inclusion-international/Adapted-Wireless-Wheely-Joystick-for-Gaming/Photos/Architecture-simple.png

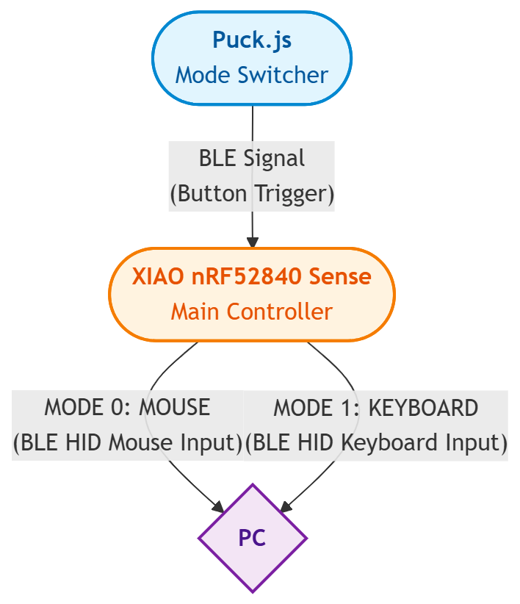
Photos/Architecture-simple.png
