inclusion-international/Adapted-Wireless-Wheely-Joystick-for-Gaming/Photos/Wireless-Knee-Button.png

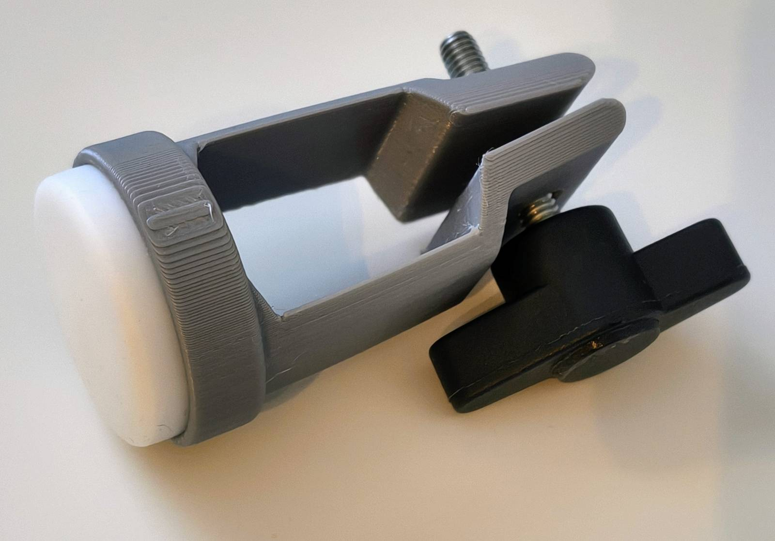
Photos/Wireless-Knee-Button.png
