inclusion-international/Adapted-Wireless-Wheely-Joystick-for-Gaming/src/xiao/XIAO-nRF52840-Sense/XIAO-nRF52840-Sense.ino

/*
 * XIAO nRF52840 Sense — MOUSE & KEYBOARD DUAL MODE
 * Features: -127 to +127 Integer Mapping, Wide Keyboard Deadzone, Hysteresis
 */

#include <bluefruit.h>
#include <LSM6DS3.h>
#include <Wire.h>

// ── HID REPORT DESCRIPTOR ────────────────────
uint8_t const desc_hid_report[] = {
  TUD_HID_REPORT_DESC_MOUSE(HID_REPORT_ID(1)),
  TUD_HID_REPORT_DESC_KEYBOARD(HID_REPORT_ID(2))
};

BLEHidGeneric blehid(2, 0, 0);

// ── IMU ──────────────────────────────────────
LSM6DS3 imu(I2C_MODE, 0x6A);

// ── CONNECTION STATE ──────────────────────────
volatile int mode = 1;  // 0 = Mouse, 1 = Keyboard
uint16_t pcConnHandle = BLE_CONN_HANDLE_INVALID;
uint16_t puckHandle = BLE_CONN_HANDLE_INVALID;

// ── KEYBOARD STATE VARIABLES ──────────────────
bool isUpPressed = false;
bool isDownPressed = false;
bool isLeftPressed = false;
bool isRightPressed = false;

// ── DEFERRED GATT DISCOVERY ───────────────────
volatile bool pendingPuckDiscovery = false;
volatile uint32_t puckConnectedAt = 0;
#define GATT_DISCOVERY_DELAY_MS 500

// ── PUCK UUIDS ───────────────────────────────
const uint8_t PUCK_SVC_UUID[] = {
  0xee, 0x86, 0x7d, 0x8e, 0x90, 0xa4, 0x4f, 0x0a,
  0x00, 0x0b, 0x00, 0x00, 0x0f, 0xf8, 0x71, 0xdf
};
const uint8_t PUCK_CHR_UUID[] = {
  0xee, 0x86, 0x7d, 0x8e, 0x90, 0xa4, 0x4f, 0x0a,
  0x00, 0x0b, 0x01, 0x00, 0x0f, 0xf8, 0x71, 0xdf
};

BLEClientService puckSvc(PUCK_SVC_UUID);
BLEClientCharacteristic puckChar(PUCK_CHR_UUID);

// ── HID SEND ──────────────────────────────────
void sendMouse(int8_t x, int8_t y) {
  if (pcConnHandle == BLE_CONN_HANDLE_INVALID) return;
  hid_mouse_report_t r = { 0 };
  r.x = x;
  r.y = y;
  blehid.inputReport(1, &r, sizeof(r));
}

void sendKeyboard() {
  if (pcConnHandle == BLE_CONN_HANDLE_INVALID) return;

  hid_keyboard_report_t r = { 0 };
  int keyIndex = 0;

  if (isUpPressed && keyIndex < 6) r.keycode[keyIndex++] = HID_KEY_W;
  if (isDownPressed && keyIndex < 6) r.keycode[keyIndex++] = HID_KEY_S;
  if (isLeftPressed && keyIndex < 6) r.keycode[keyIndex++] = HID_KEY_A;
  if (isRightPressed && keyIndex < 6) r.keycode[keyIndex++] = HID_KEY_D;

  blehid.inputReport(2, &r, sizeof(r));
}

// ── PUCK NOTIFY CALLBACK ──────────────────────
void notifyCb(BLEClientCharacteristic* chr, uint8_t* data, uint16_t len) {
  if (len > 0) {
    mode = data[0];
    Serial.printf("[PUCK] Mode -> %d (%s)\n",
                  mode, mode == 0 ? "MOUSE" : "KEYBOARD");

    if (mode == 0) {
      isUpPressed = isDownPressed = isLeftPressed = isRightPressed = false;
      sendKeyboard();
    }
  }
}

// ── SCAN CALLBACK ─────────────────────────────
void scanCb(ble_gap_evt_adv_report_t* report) {
  uint8_t nameBuf[32] = { 0 };
  uint8_t nameLen = Bluefruit.Scanner.parseReportByType(
    report, BLE_GAP_AD_TYPE_COMPLETE_LOCAL_NAME,
    nameBuf, sizeof(nameBuf));
  
// Configure the name of the Puck.js device to be used for the mode change (MOUSE/KEYBOARD).
  if (nameLen == 12 && memcmp(nameBuf, "Puck.js e11f", 3) == 0) {
    Serial.println("[SCAN] Found 'Puck.js', connecting...");
    Bluefruit.Scanner.stop();
    Bluefruit.Central.connect(report);
    return;
  } else {
    Serial.println("Could not find 'Puck.js'");
  }
  Bluefruit.Scanner.resume();
}

// ── CONNECT CALLBACK ──────────────────────────
void connectCb(uint16_t handle) {
  BLEConnection* conn = Bluefruit.Connection(handle);
  if (!conn) return;

  if (conn->getRole() == BLE_GAP_ROLE_PERIPH) {
    pcConnHandle = handle;
    conn->requestConnectionParameter(6, 12);
    Serial.println("[BLE] PC connected (HID host)");
  } else {
    puckHandle = handle;
    Bluefruit.Scanner.stop();
    conn->requestConnectionParameter(80, 160);
    pendingPuckDiscovery = true;
    puckConnectedAt = millis();
    Serial.println("[BLE] Puck link up — discovery scheduled in 500ms");
  }
}

// ── DISCONNECT CALLBACK ───────────────────────
void disconnectCb(uint16_t handle, uint8_t reason) {
  if (handle == pcConnHandle) {
    pcConnHandle = BLE_CONN_HANDLE_INVALID;
    isUpPressed = isDownPressed = isLeftPressed = isRightPressed = false;
    Serial.printf("[BLE] PC disconnected (reason=0x%02X)\n", reason);
    Bluefruit.Advertising.start(0);

  } else if (handle == puckHandle) {
    puckHandle = BLE_CONN_HANDLE_INVALID;
    pendingPuckDiscovery = false;
    Serial.printf("[BLE] Puck disconnected (reason=0x%02X)\n", reason);
    Bluefruit.Scanner.start(0);
  }
}

// ── SETUP ─────────────────────────────────────
void setup() {
  Serial.begin(115200);

  Wire.begin();
  Wire.setClock(400000);

  if (imu.begin() != 0) {
    Serial.println("[ERROR] IMU init failed");
    while (1)
      ;
  }

  Bluefruit.begin(1, 1);
  Bluefruit.setName("XIAO-HID");

  blehid.setReportMap(desc_hid_report, sizeof(desc_hid_report));
  blehid.begin();

  puckSvc.begin();
  puckChar.begin();

  Bluefruit.Periph.setConnectCallback(connectCb);
  Bluefruit.Periph.setDisconnectCallback(disconnectCb);
  Bluefruit.Central.setConnectCallback(connectCb);
  Bluefruit.Central.setDisconnectCallback(disconnectCb);

  Bluefruit.Advertising.addFlags(BLE_GAP_ADV_FLAGS_LE_ONLY_GENERAL_DISC_MODE);
  Bluefruit.Advertising.addAppearance(BLE_APPEARANCE_HID_MOUSE);
  Bluefruit.Advertising.addService(blehid);
  Bluefruit.Advertising.addName();
  Bluefruit.Advertising.start(0);

  Bluefruit.Scanner.setRxCallback(scanCb);
  Bluefruit.Scanner.useActiveScan(true);
  Bluefruit.Scanner.setInterval(160, 160);
  Bluefruit.Scanner.start(0);

  Serial.println("[SYSTEM] Ready");
}

// ── LOOP ──────────────────────────────────────
void loop() {
  static uint32_t lastPrintMs = 0;
  static uint32_t sendCount = 0;
  static uint32_t lastHidMs = 0;

  if (millis() - lastPrintMs >= 1000) {
    lastPrintMs = millis();
    if (sendCount > 0) Serial.printf("[HID] %lu report/s\n", sendCount);
    sendCount = 0;
  }

  if (pendingPuckDiscovery && (millis() - puckConnectedAt >= GATT_DISCOVERY_DELAY_MS)) {
    pendingPuckDiscovery = false;
    if (puckHandle != BLE_CONN_HANDLE_INVALID && puckSvc.discover(puckHandle) && puckChar.discover()) {
      puckChar.setNotifyCallback(notifyCb);
      puckChar.enableNotify();
      Serial.println("[GATT] Puck discovery OK + notify enabled");
    } else {
      Serial.println("[GATT] Puck discovery failed — forcing reconnect");
      if (puckHandle != BLE_CONN_HANDLE_INVALID) {
        Bluefruit.disconnect(puckHandle);
      }
    }
  }

    // ── SENSOR READING AND PROCESSING @ ~66Hz ─────────────────
  if (millis() - lastHidMs >= 15) {
    lastHidMs = millis();

    if (pcConnHandle == BLE_CONN_HANDLE_INVALID) return;

    float ax = imu.readFloatAccelX();
    float ay = imu.readFloatAccelY();

    if (mode == 0) {
      // ── MOUSE MODE ────────────────────────

      // Larger deadzone for DOWN movement
      const float MOUSE_DEADZONE_UP = 0.10f;
      const float MOUSE_DEADZONE_DOWN = 0.45f;

      // Corrected Y deadzone logic
      if (ay > -MOUSE_DEADZONE_UP && ay < MOUSE_DEADZONE_DOWN) {
        ay = 0.0f;
      }

      // X deadzone unchanged
      const float MOUSE_DEADZONE_X = 0.33f;
      if (fabs(ax) < MOUSE_DEADZONE_X) {
        ax = 0.0f;
      }

      int moveX = (int)(ax * 30.0f);
      int moveY = (int)(ay * 30.0f);

      if (moveX != 0 || moveY != 0) {
        int8_t fx = (int8_t)constrain(moveX, -127, 127);
        int8_t fy = (int8_t)constrain(moveY, -127, 127);

        sendMouse(-fx, fy);
        sendCount++;
      }

    } else {
      // ── KEYBOARD MODE ────────────────────────

      int valX = constrain((int)(ax * 127.0f), -127, 127);
      int valY = constrain((int)(ay * 127.0f), -127, 127);

      // Larger deadzone for S
      const int KEY_PRESS_UP = 20;    // W press threshold
      const int KEY_PRESS_DOWN = 35;  // S press threshold

      // FIXED HYSTERESIS (release thresholds must be LOWER)
      const int KEY_RELEASE_UP = 10;    // W release threshold
      const int KEY_RELEASE_DOWN = 20;  // S release threshold

      bool wantUp = false, wantDown = false, wantLeft = false, wantRight = false;

      // Y-axis decisions
      if (valY < -KEY_PRESS_UP) wantUp = true;
      else if (valY > KEY_PRESS_DOWN) wantDown = true;

      // Correct hysteresis
      if (isUpPressed && valY < -KEY_RELEASE_UP) wantUp = true;
      if (isDownPressed && valY > KEY_RELEASE_DOWN) wantDown = true;

      const int KEY_PRESS_ZONE = 30;
      const int KEY_RELEASE_ZONE = 15;

      if (valX > KEY_PRESS_ZONE) wantLeft = true;
      else if (valX < -KEY_PRESS_ZONE) wantRight = true;

      if (isLeftPressed && valX < -KEY_RELEASE_ZONE) wantLeft = true;
      if (isRightPressed && valX > KEY_RELEASE_ZONE) wantRight = true;

      if (wantUp != isUpPressed || wantDown != isDownPressed ||
          wantLeft != isLeftPressed || wantRight != isRightPressed) {

        isUpPressed = wantUp;
        isDownPressed = wantDown;
        isLeftPressed = wantLeft;
        isRightPressed = wantRight;

        sendKeyboard();
        sendCount++;
      }
    }
  } // closes 15ms timer
} // closes loop()
