inclusion-international/Adapted-Wireless-Wheely-Joystick-for-Gaming/(commit log)

2026-09-25 added knee button photo, added video demonstrating the joystick
2026-10-09 moved xiao Arduino sketch into subfolder; updated README.md accordingly
2026-10-09 added advertising of battery level
2026-10-09 set name of puck.js device to 'Puck.js e11f'
